sebadima/sentinel/images/sentinel-001.png

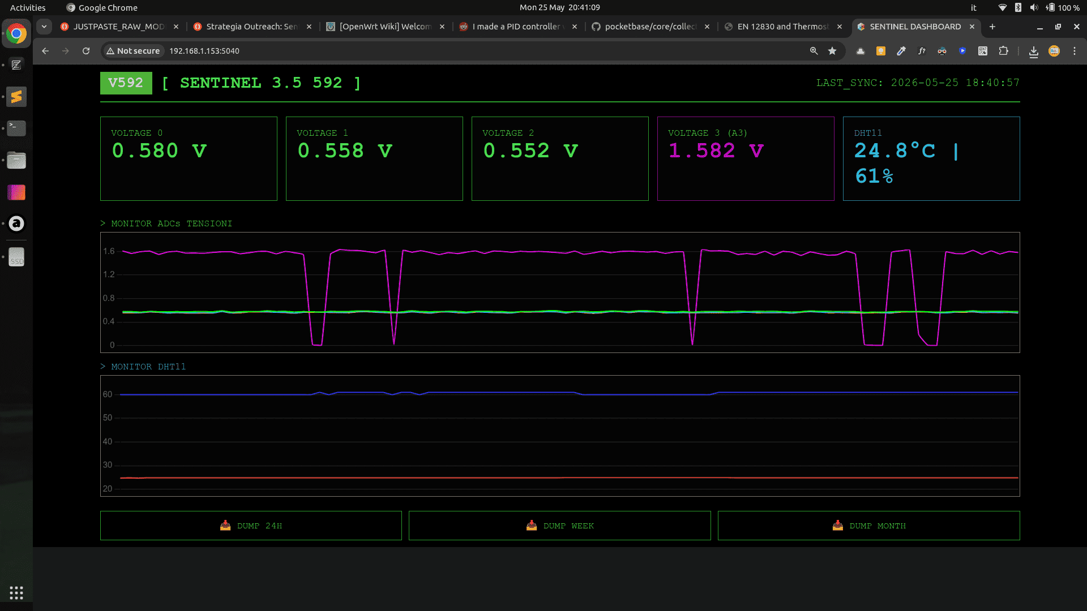
images/sentinel-001.png
