sebadima/sentinel/images/sentinel-002.png

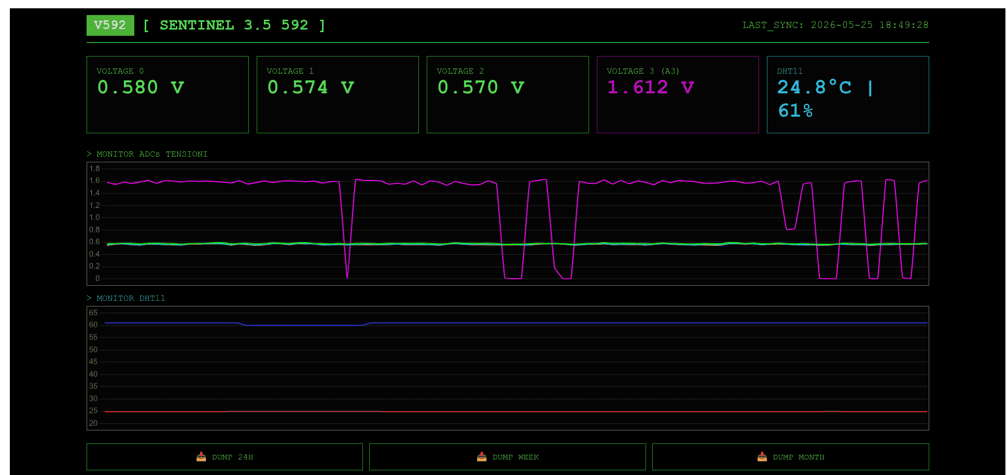
images/sentinel-002.png
