sebadima/sentinel/images/sentinel-003.png

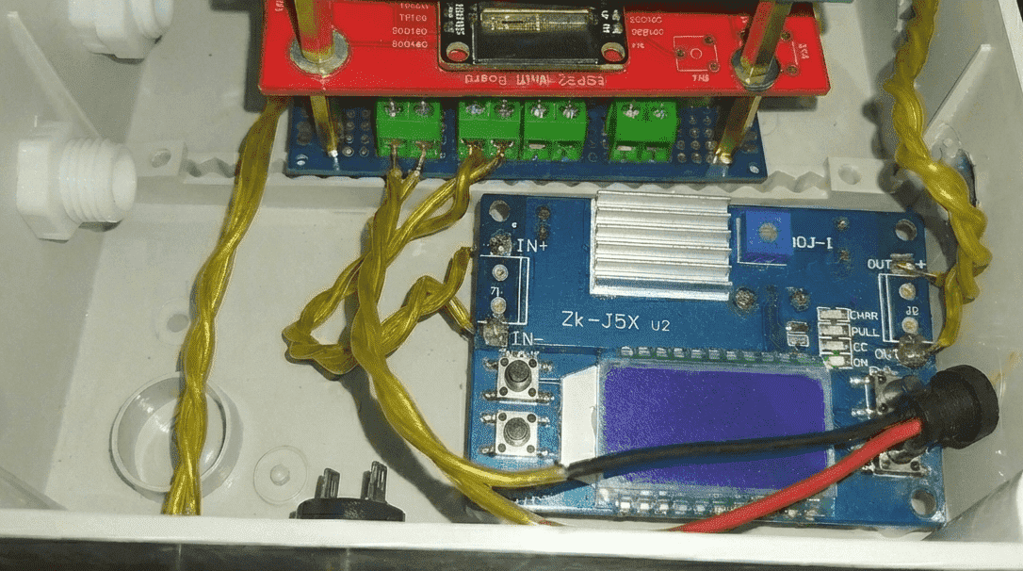
images/sentinel-003.png
