sebadima/sentinel/images/sentinel-008.jpeg

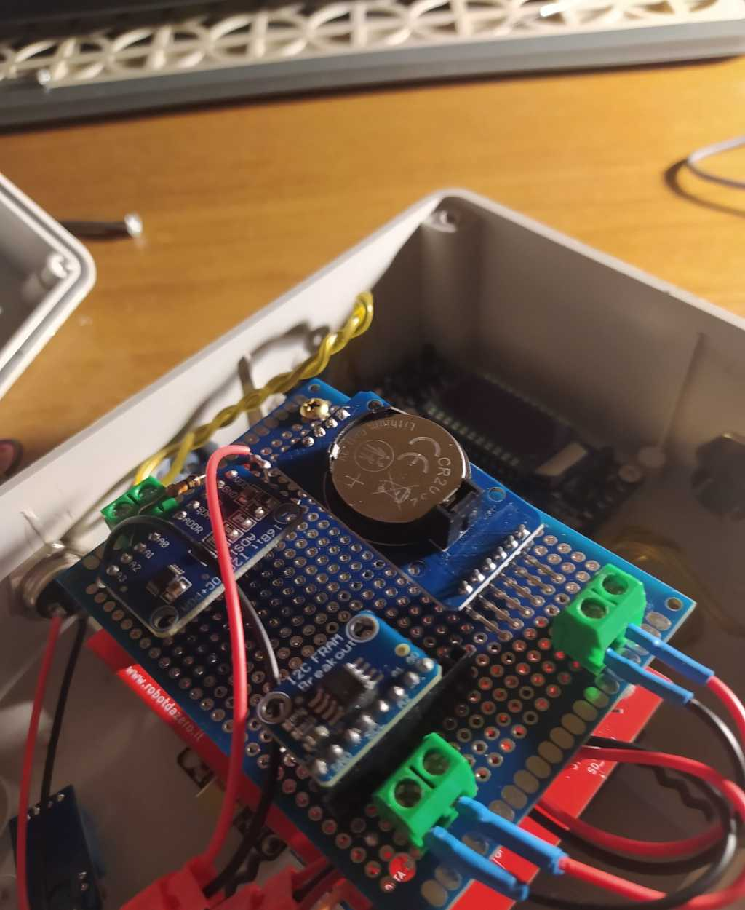
images/sentinel-008.jpeg
