sebadima/sentinel/images/sentinel-009.jpeg

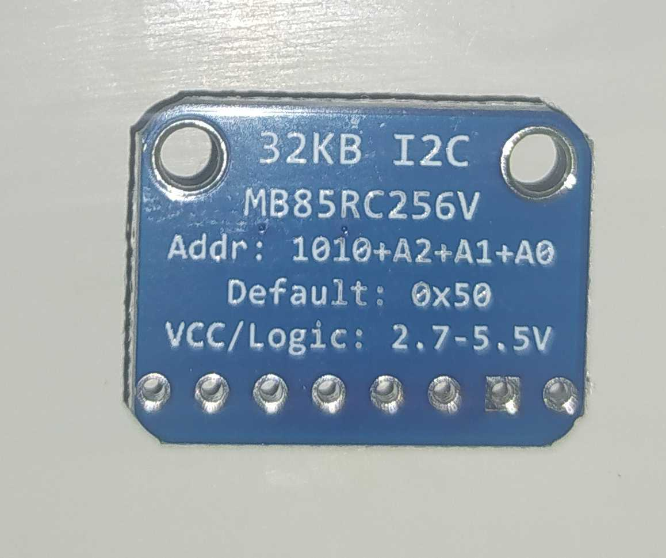
images/sentinel-009.jpeg
