sebadima/sentinel/images/sentinel-011.jpg

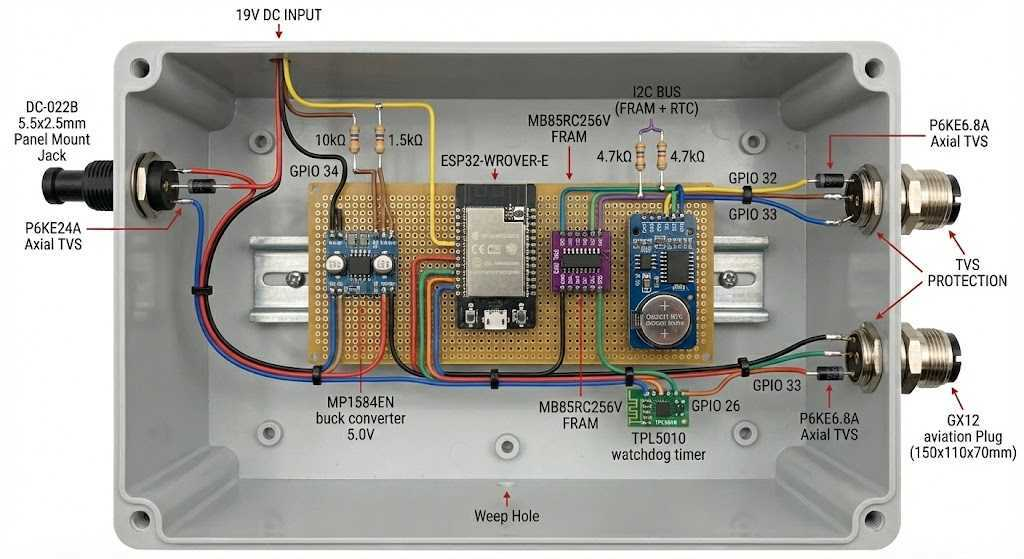
images/sentinel-011.jpg
