sebadima/sentinel/images/sentinel-012.jpeg

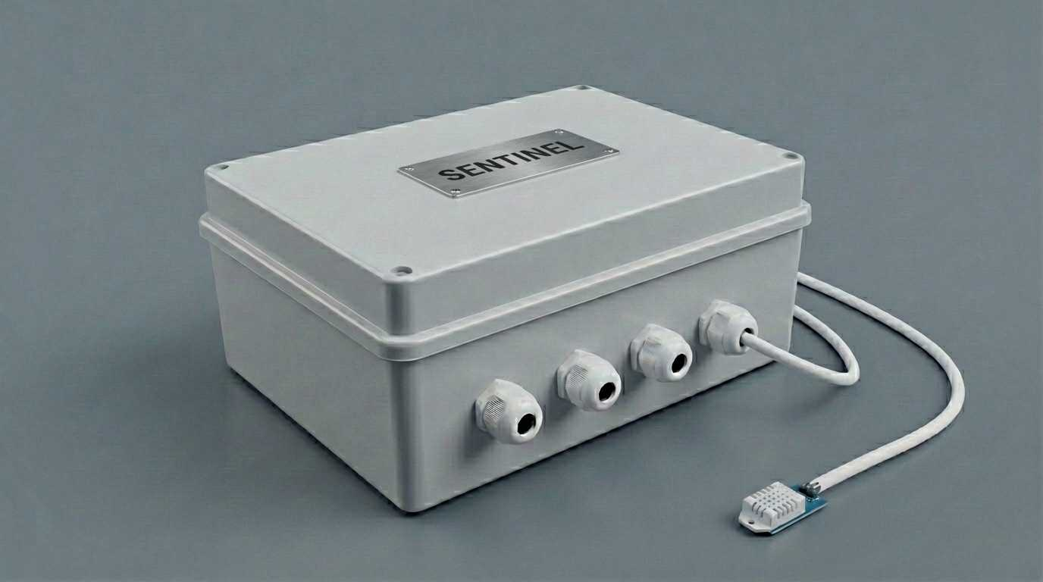
images/sentinel-012.jpeg
