sebadima/sentinel/images/sentinel-015.jpeg

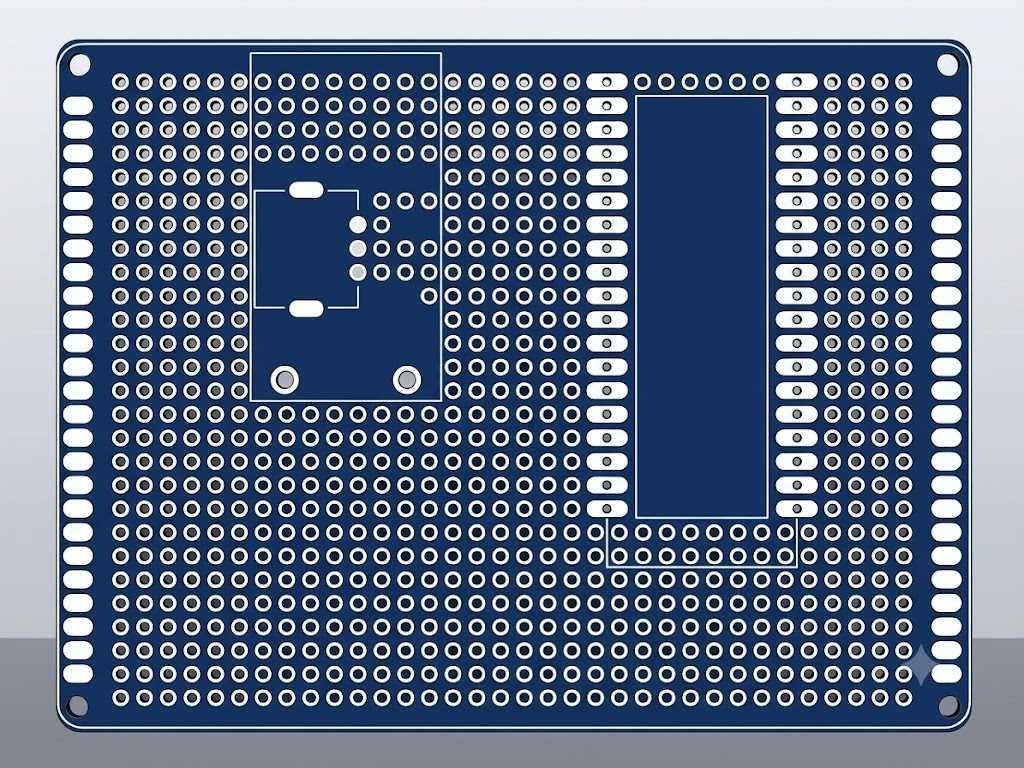
images/sentinel-015.jpeg
