sebadima/sentinel/images/sentinel-016.jpeg

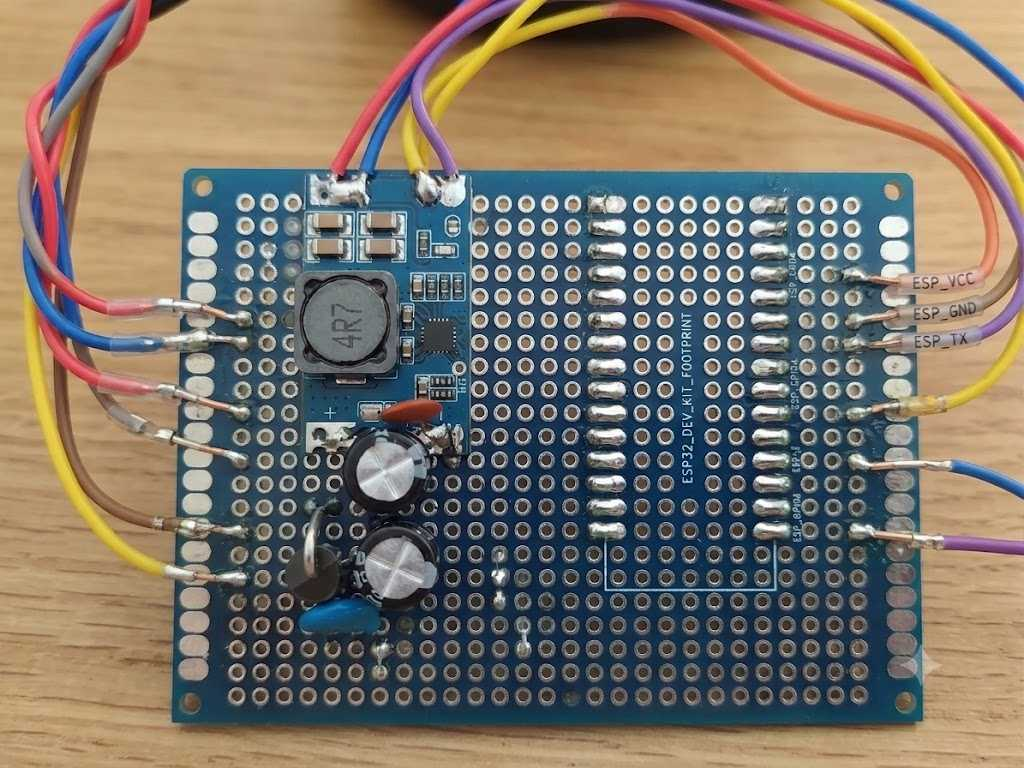
images/sentinel-016.jpeg
