sebadima/sentinel/images/sentinel-017.jpeg

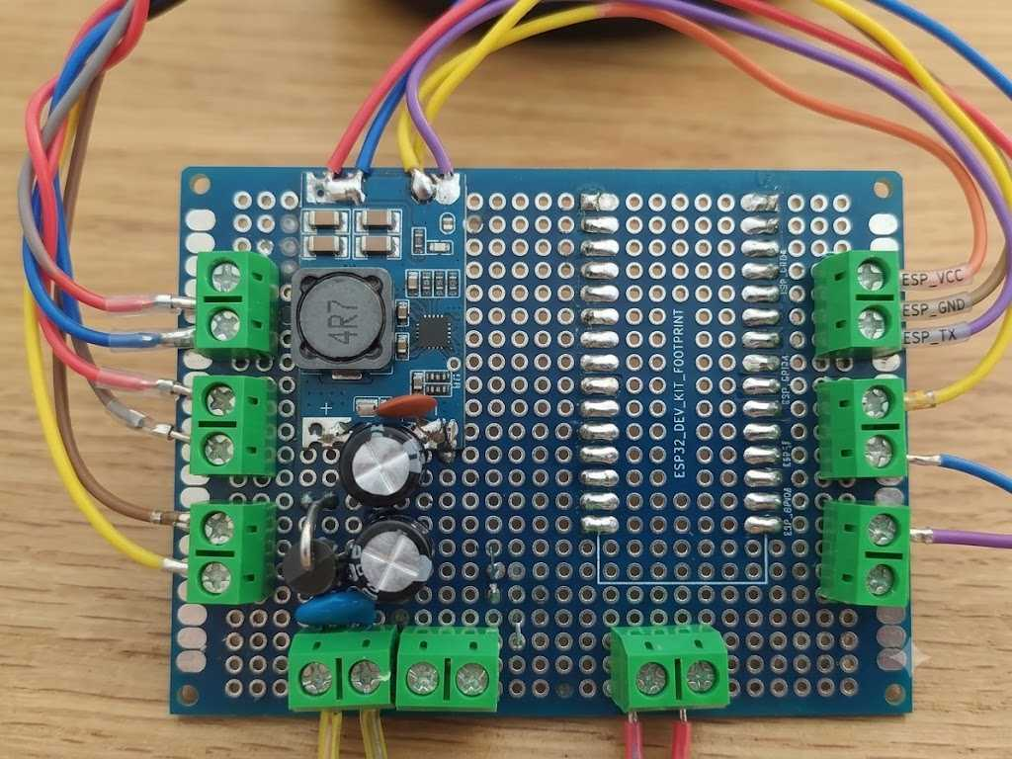
images/sentinel-017.jpeg
