sebadima/sentinel/images/sentinel-018.jpeg

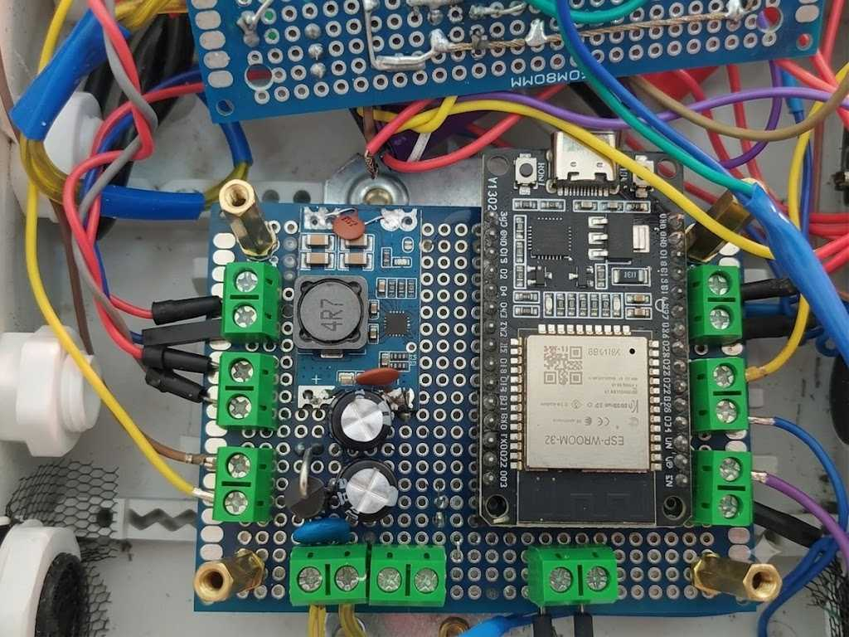
images/sentinel-018.jpeg
