sebadima/sentinel/images/sentinel-019.png

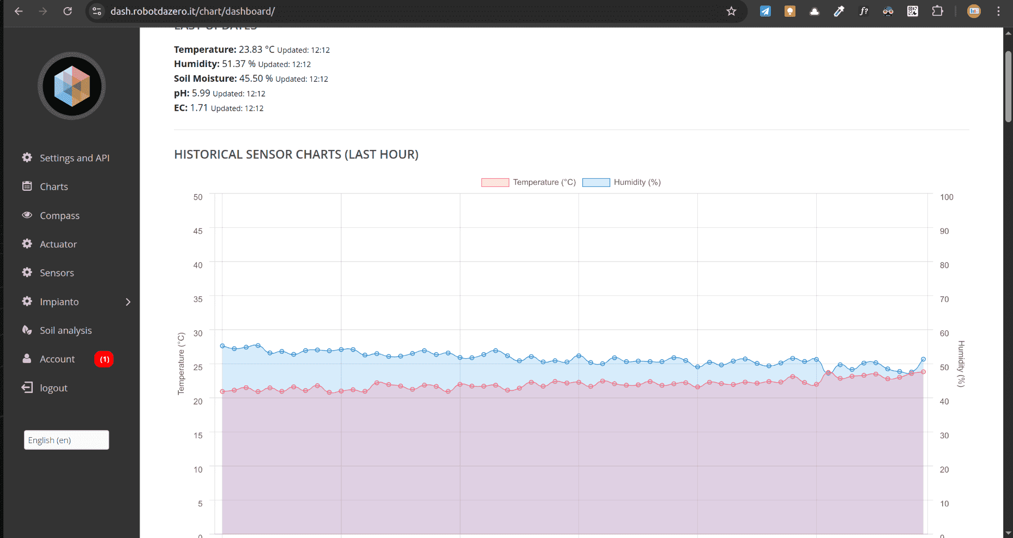
images/sentinel-019.png
