sebadima/sentinel/images/sentinel-020.png

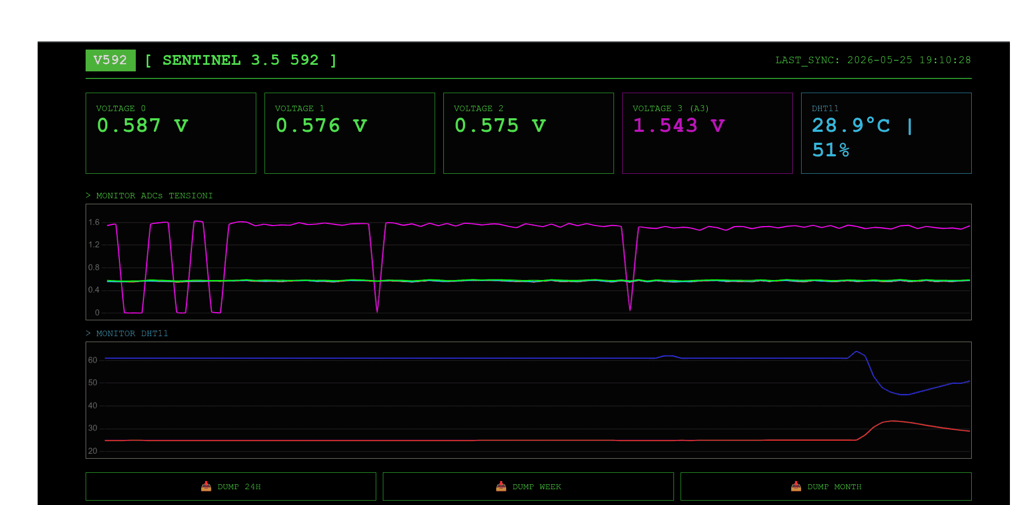
images/sentinel-020.png
