sebadima/sentinel/images/sentinel-021.png

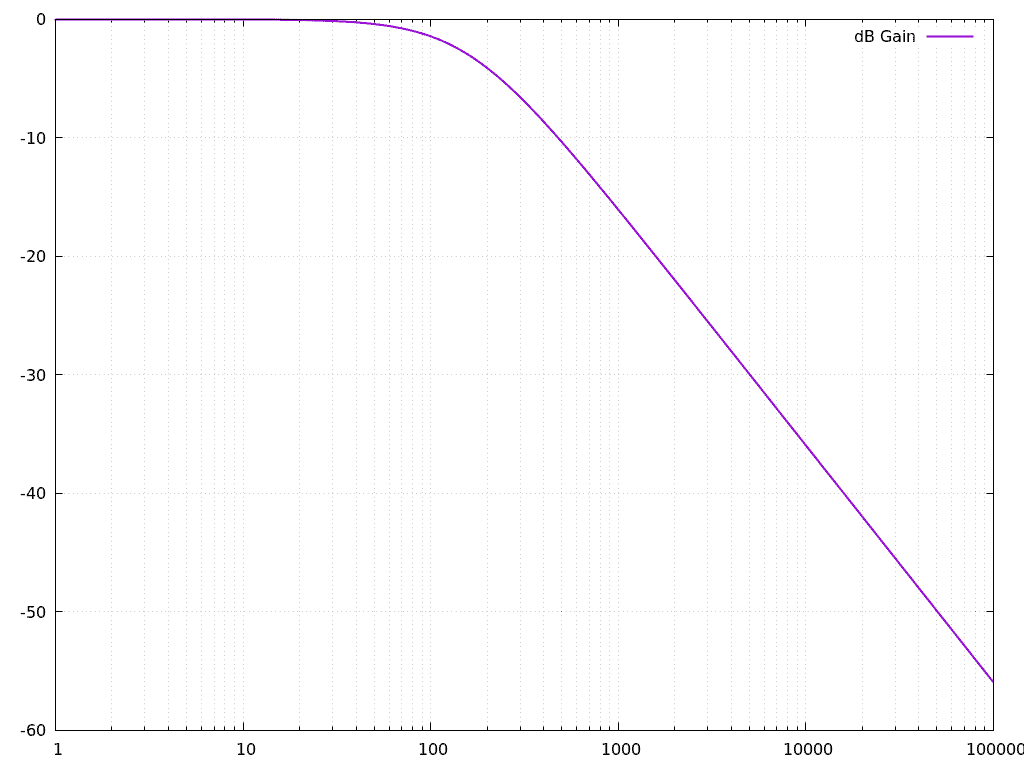
images/sentinel-021.png
