sebadima/sentinel/images/sentinel-022.jpg

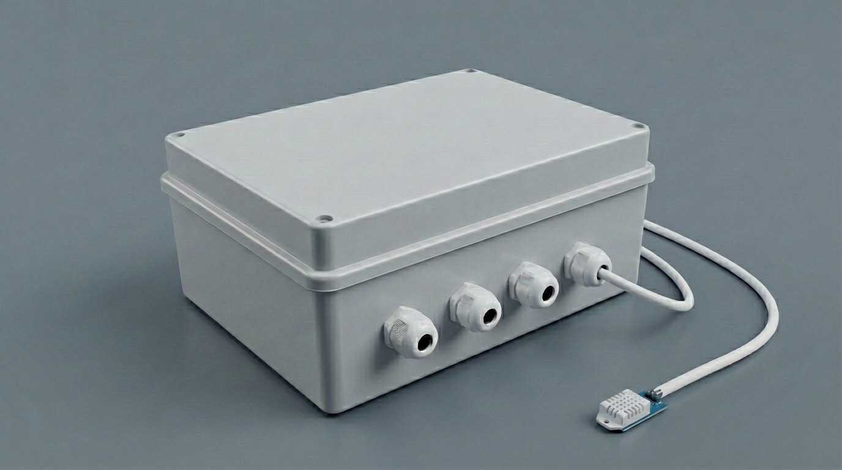
images/sentinel-022.jpg
