sebadima/sentinel/images/sentinel-023.jpg

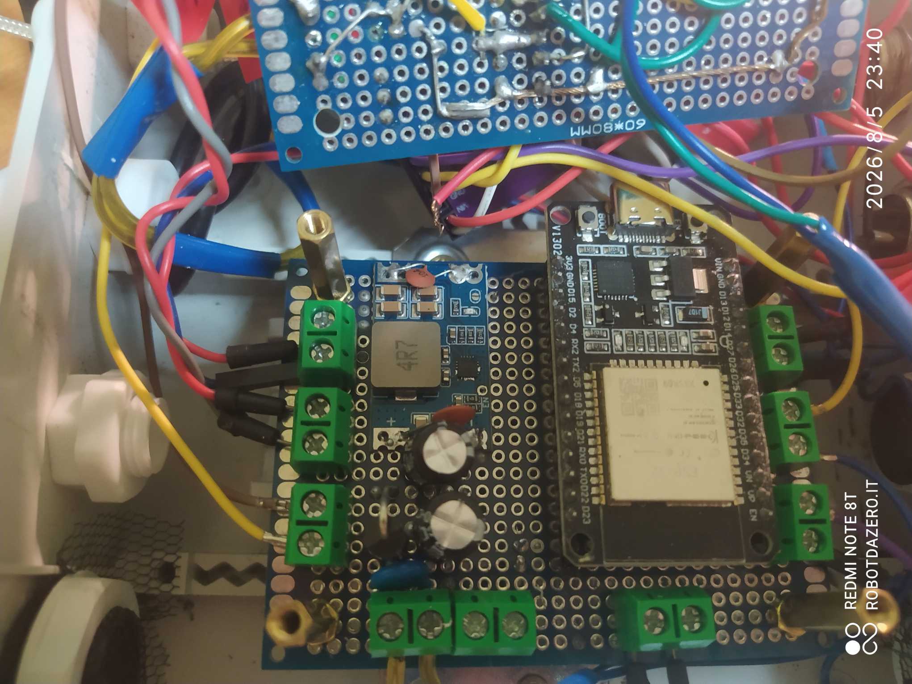
images/sentinel-023.jpg
