sebadima/sentinel/images/sentinel-025.jpg

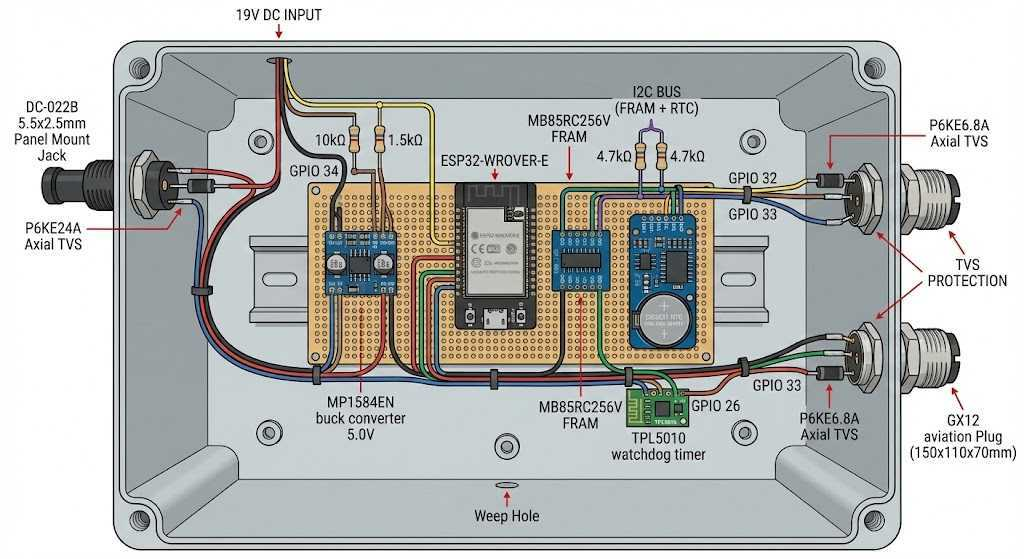
images/sentinel-025.jpg
