sebadima/sentinel/images/sentinel-026.png

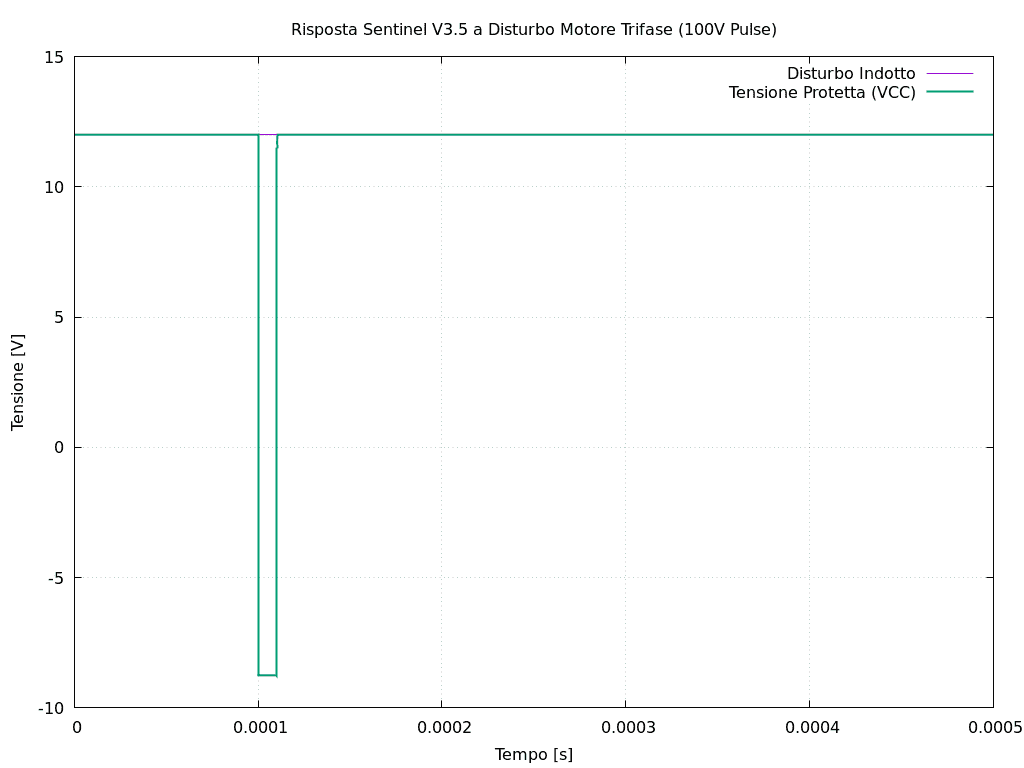
images/sentinel-026.png
