sebadima/sentinel/images/sentinel-027.png

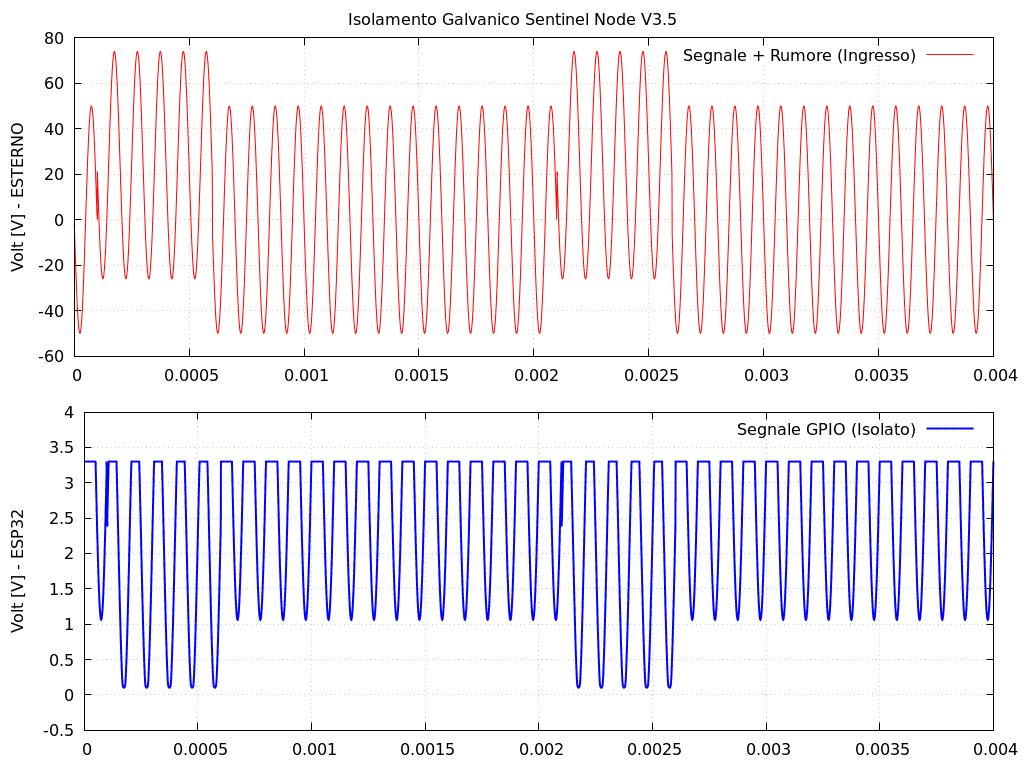
images/sentinel-027.png
